JeremyProffittOrg/adafruit-pannel/docs/stl-kit.pdf

# STL isometric kit

## Base plates

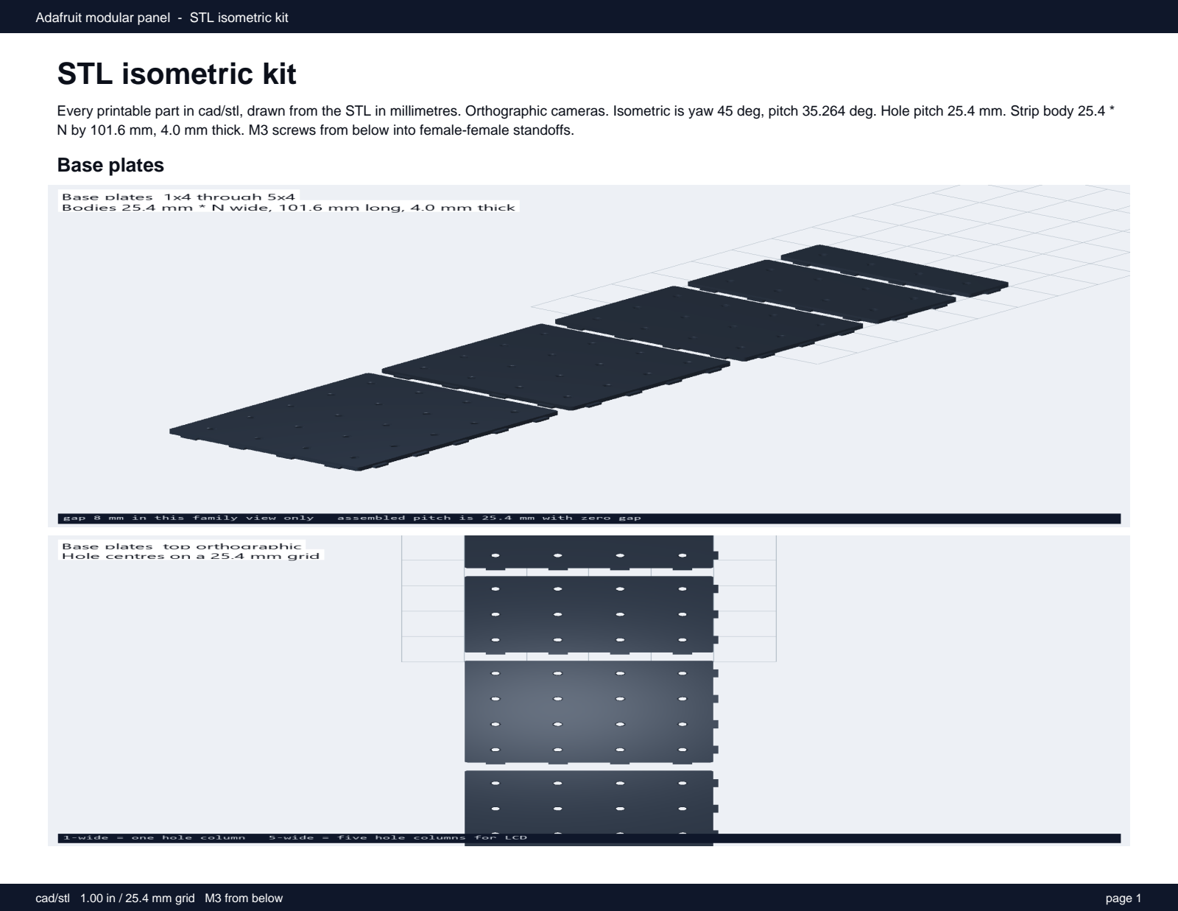
[picture p1: page 1]

Adafruit modular panel - STL isometric kit

cad/stl 1.00 in / 25.4 mm grid M3 from below | page 1

Every printable part in cad/stl, drawn from the STL in millimetres. Orthographic cameras. Isometric is yaw 45 deg, pitch 35.264 deg. Hole pitch 25.4 mm. Strip body 25.4 * N by 101.6 mm, 4.0 mm thick. M3 screws from below into female-female standoffs.

## Assembled 5-wide base and exploded stack

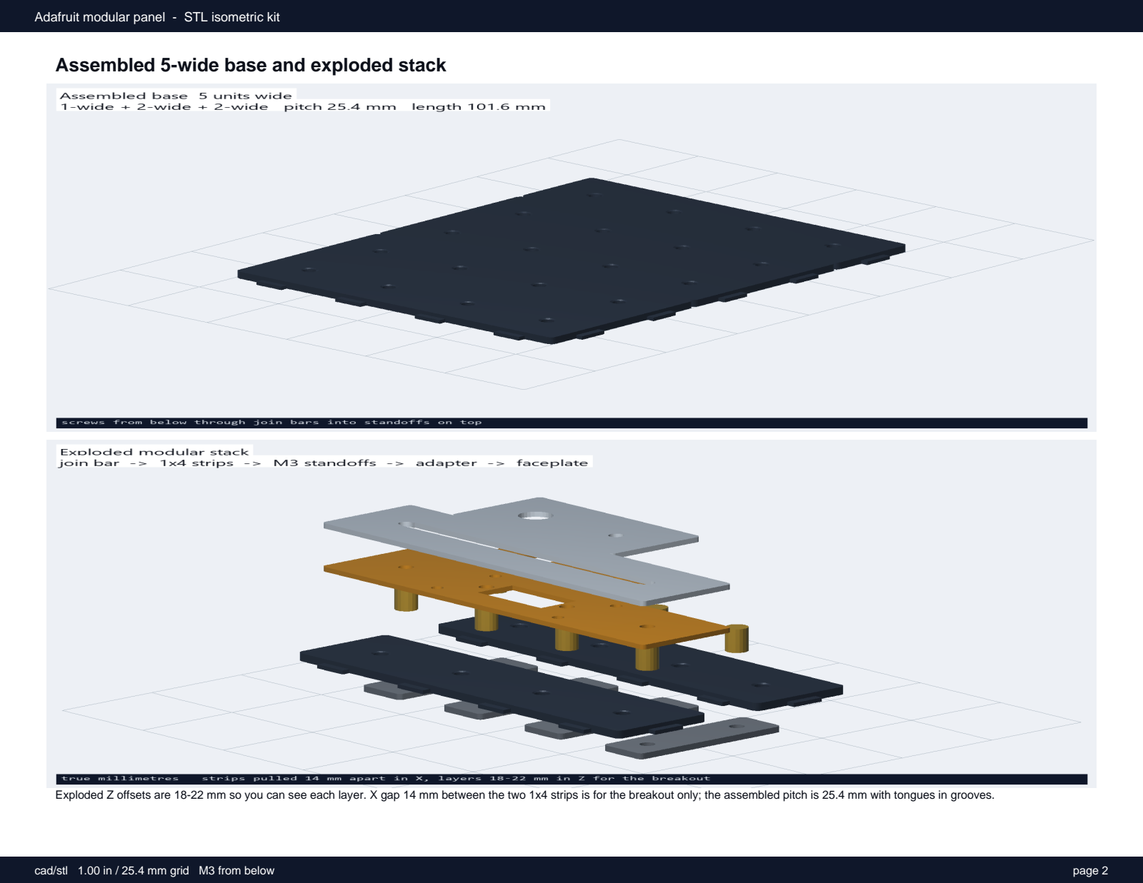
[picture p2: page 2]

Exploded Z offsets are 18-22 mm so you can see each layer. X gap 14 mm between the two 1x4 strips is for the breakout only; the assembled pitch is 25.4 mm with tongues in grooves.

## Base strip 1 x 4 (25.4 x 101.6 mm body)

Top-left isometric. Top-right reverse isometric. Bottom-left top ortho. Bottom-right side ortho.

## Base strip 2 x 4 (50.8 x 101.6 mm body)

Top-left isometric. Top-right reverse isometric. Bottom-left top ortho. Bottom-right side ortho.

## Base strip 3 x 4 (76.2 x 101.6 mm body)

Top-left isometric. Top-right reverse isometric. Bottom-left top ortho. Bottom-right side ortho.

## Base strip 4 x 4 (101.6 x 101.6 mm body)

Top-left isometric. Top-right reverse isometric. Bottom-left top ortho. Bottom-right side ortho.

## Base strip 5 x 4 (127.0 x 101.6 mm body, LCD)

Top-left isometric. Top-right reverse isometric. Bottom-left top ortho. Bottom-right side ortho.

## Join bar (40 x 12 x 3 mm, two M3 at 25.4 mm)

Top-left isometric. Top-right reverse isometric. Bottom-left top ortho. Bottom-right side ortho.

## Adapter 4991 / 5880 rotary (1 x 2 cells)

Top-left isometric. Top-right reverse isometric. Bottom-left top ortho. Bottom-right side ortho.

## Adapter 5295 NeoSlider (1 x 4 cells)

Top-left isometric. Top-right reverse isometric. Bottom-left top ortho. Bottom-right side ortho.

## Adapter 5752 quad rotary (1 x 4 cells)

Top-left isometric. Top-right reverse isometric. Bottom-left top ortho. Bottom-right side ortho.

## Adapter 6310 ANO (2 x 2 cells)

Top-left isometric. Top-right reverse isometric. Bottom-left top ortho. Bottom-right side ortho.

## Faceplate 4991 / 5880 (7.5 mm shaft hole)

Top-left isometric. Top-right reverse isometric. Bottom-left top ortho. Bottom-right side ortho.

## Faceplate 5295 (75 x 4 mm slider slot)

Top-left isometric. Top-right reverse isometric. Bottom-left top ortho. Bottom-right side ortho.

## Faceplate 5752 (four 7.5 mm shaft holes)

Top-left isometric. Top-right reverse isometric. Bottom-left top ortho. Bottom-right side ortho.

## Faceplate 6310 (22 mm click-wheel hole)

Top-left isometric. Top-right reverse isometric. Bottom-left top ortho. Bottom-right side ortho.
