JeremyProffittOrg/adafruit-pannel/docs/case-parts.pdf

Adafruit modular case - two-piece print kit

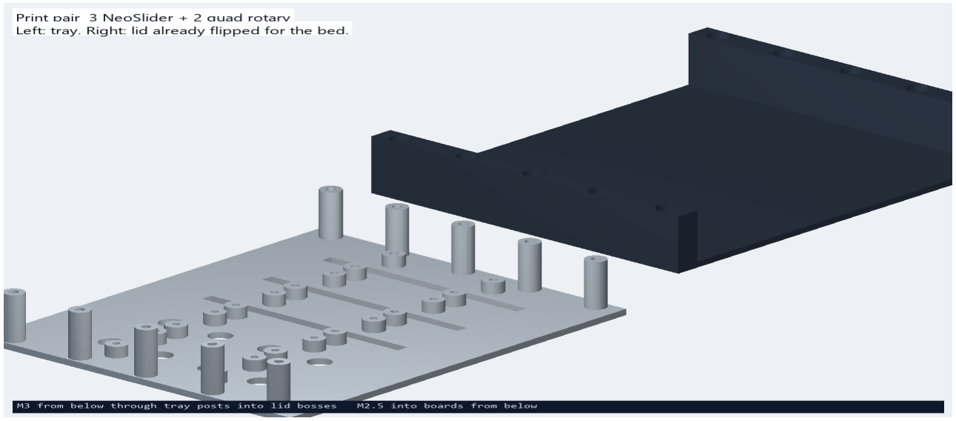
[picture p5: figure]

bottom tray + top lid 5 x 4 x 25 mm inside | page 1

# Two-piece case print kit

Bottom tray and top lid for 3 NeoSliders beside 2 quad rotaries. 5 x 4 cells, 25 mm inside. Top is already flipped: put the STL on the bed as exported. Boards screw into bosses under the lid. M3 screws come from below through the tray into the lid posts.

## Print pair

## Fit test — flip the lid over

The lid STL is already upside down for the bed. Flip it 180 deg so the posts point down, then drop it onto the two side walls. Front and back of the tray are open.

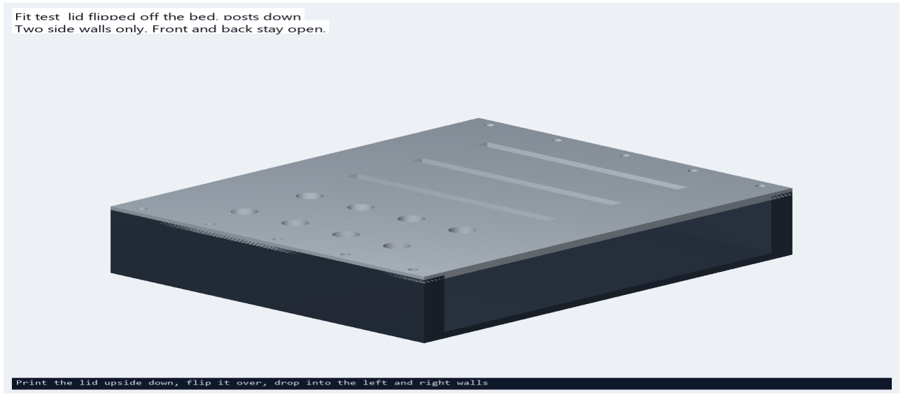
[picture p6: figure]

## Bottom tray

Iso, reverse iso, top ortho, side ortho. Millimetres from the STL.

## Top lid (print orientation)

Iso, reverse iso, top ortho, side ortho. Millimetres from the STL.

## Tilted tray demo

Iso, reverse iso, top ortho, side ortho. Millimetres from the STL.

## Tilted lid demo

Iso, reverse iso, top ortho, side ortho. Millimetres from the STL.
