JeremyProffittOrg/adafruit-pannel/cad/stl/faceplate_6310.stl

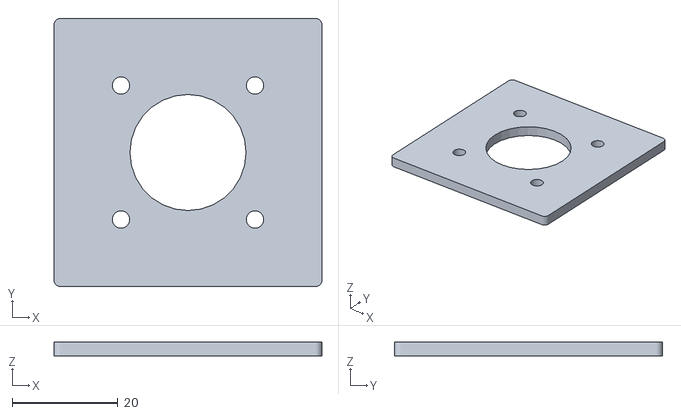
[picture p7: CAD file, 2026-09-19]
cad/stl/faceplate_6310.stl
50.8 x 50.8 x 2.60
