JeremyProffittOrg/adafruit-pannel/print-kits/sliders-quads-case/face-tilt-top.stl

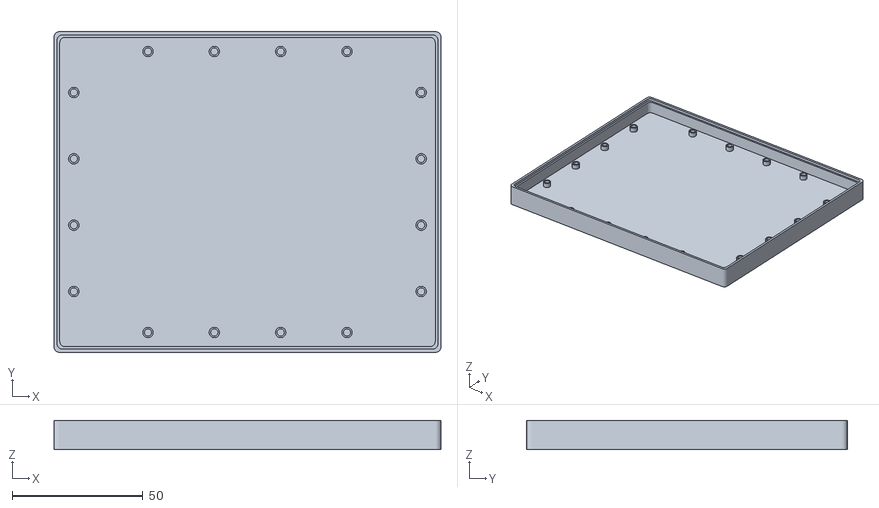
[picture p8: CAD file, 2026-09-20]
print-kits/sliders-quads-case/face-tilt-top.stl
148.2 x 122.8 x 11.2
