JeremyProffittOrg/adafruit-pannel/cad/stl/adapter_5295.stl

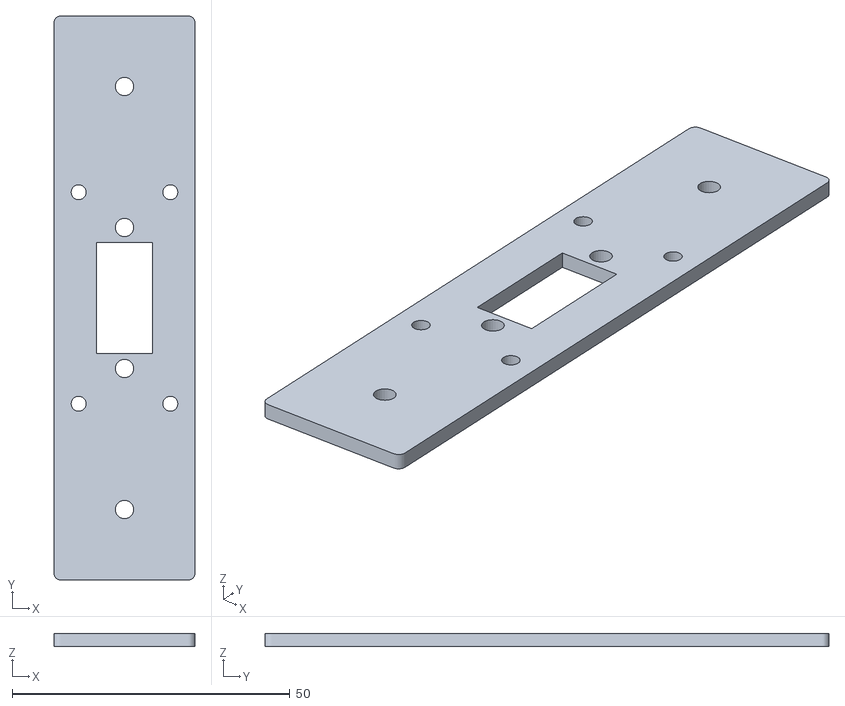
[picture p9: CAD file, 2026-09-19]
cad/stl/adapter_5295.stl
25.4 x 101.6 x 2.40
