JeremyProffittOrg/adafruit-pannel/print-kits/sliders-quads-case/top.stl

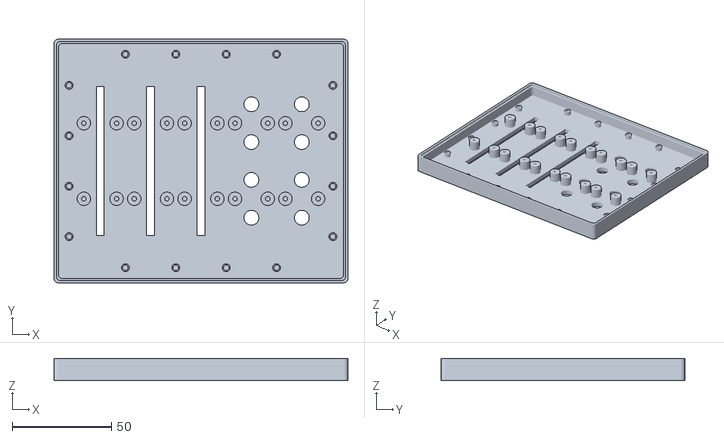
[picture p10: CAD file, 2026-09-20]
print-kits/sliders-quads-case/top.stl
148.2 x 122.8 x 11.2
