JeremyProffittOrg/adafruit-pannel/cad/stl/strip_5x4.stl

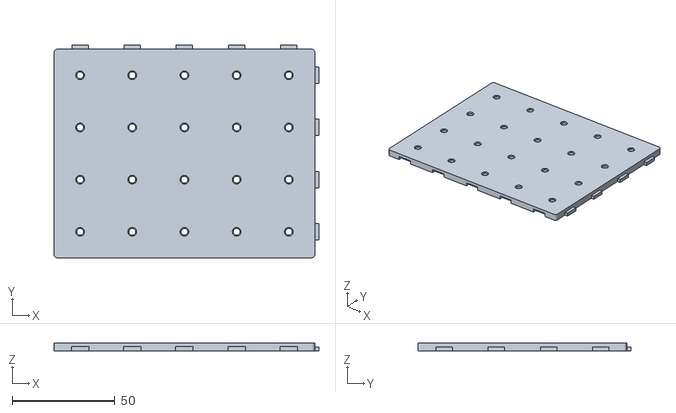
[picture p11: CAD file, 2026-09-19]
cad/stl/strip_5x4.stl
129.0 x 103.6 x 4.00
