JeremyProffittOrg/adafruit-pannel/print-kits/sliders-quads-case/bottom.stl

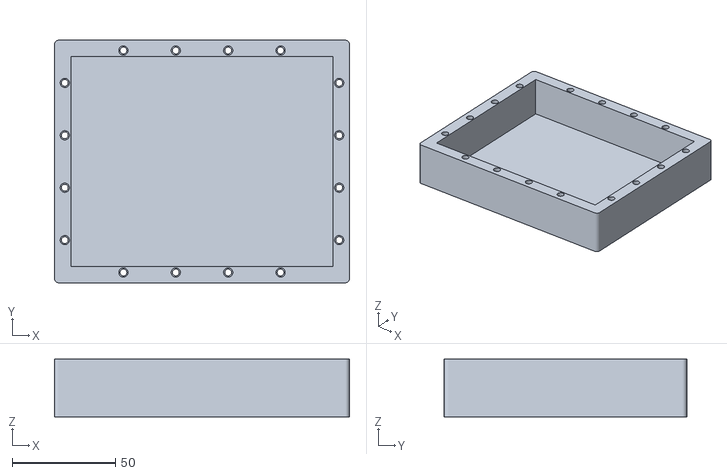
[picture p12: CAD file, 2026-09-20]
print-kits/sliders-quads-case/bottom.stl
143.0 x 117.6 x 28.0
