JeremyProffittOrg/adafruit-pannel/cad/stl/faceplate_5295.stl

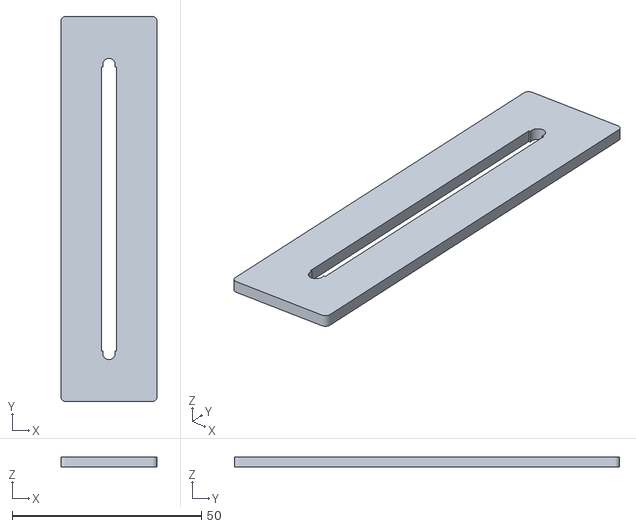
[picture p13: CAD file, 2026-09-19]
cad/stl/faceplate_5295.stl
25.4 x 101.6 x 2.60
