JeremyProffittOrg/adafruit-pannel/print-kits/sliders-quads-case/face-tilt-bottom.stl

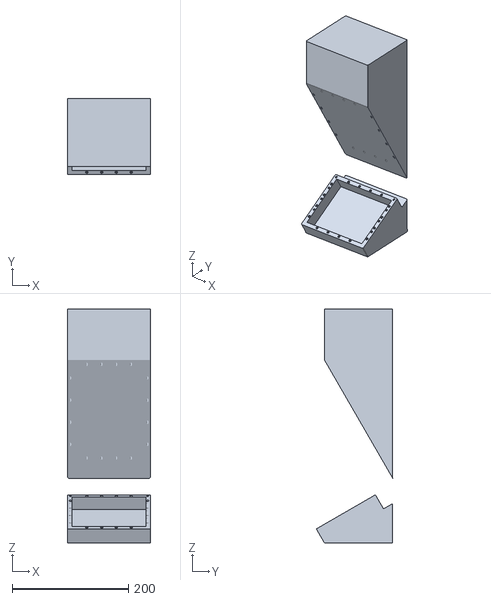
[picture p14: CAD file, 2026-09-20]
print-kits/sliders-quads-case/face-tilt-bottom.stl
143.0 x 131.6 x 403.0
