JeremyProffittOrg/adafruit-pannel/cad/stl/strip_1x4.stl

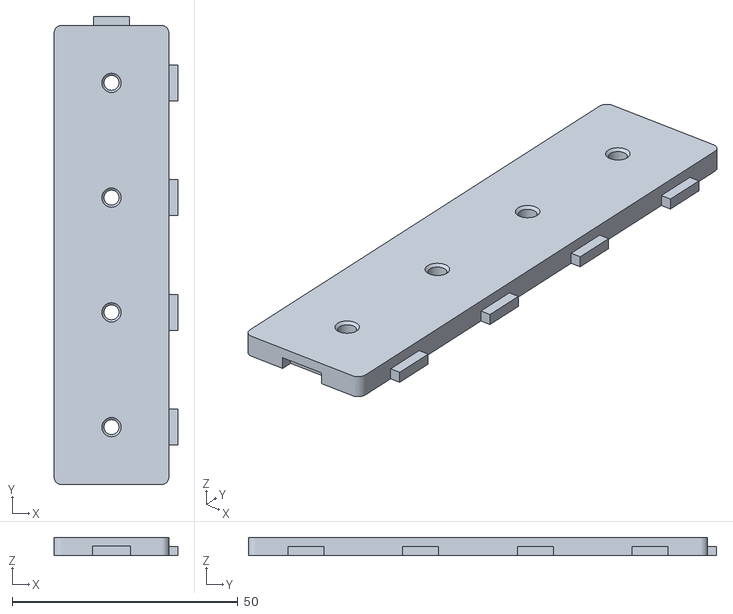
[picture p15: CAD file, 2026-09-19]
cad/stl/strip_1x4.stl
27.4 x 103.6 x 4.00
