JeremyProffittOrg/adafruit-pannel/print-kits/sliders-quads-case/sliders-quads-case.3mf

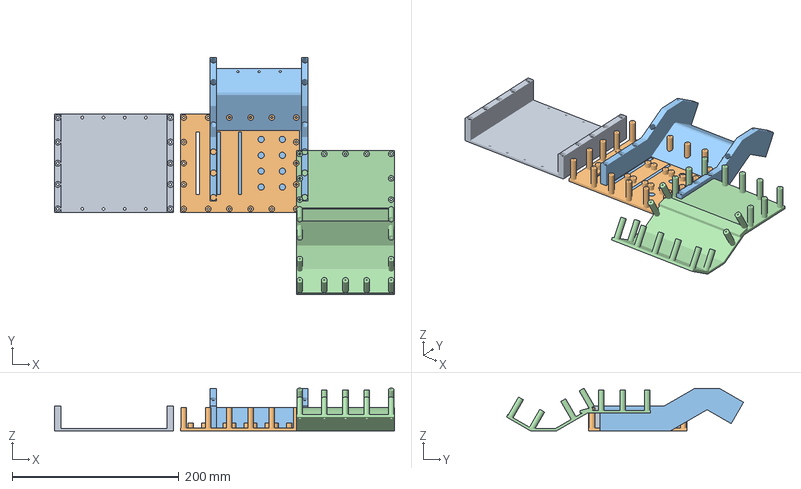
[picture p16: CAD file, 2026-09-20]
print-kits/sliders-quads-case/sliders-quads-case.3mf
407.8 x 284.4 x 51.3 mm
bottom.stl
top.stl
tilt-bottom.stl
tilt-top.stl
