JeremyProffittOrg/adafruit-pannel/cad/stl/faceplate_5752.stl

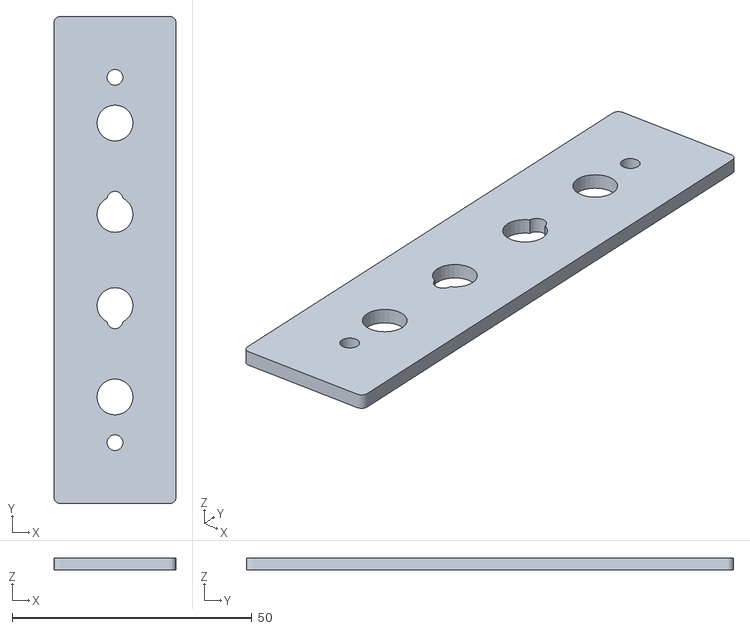
[picture p17: CAD file, 2026-09-19]
cad/stl/faceplate_5752.stl
25.4 x 101.6 x 2.60
