JeremyProffittOrg/adafruit-pannel/cad/stl/adapter_4991.stl

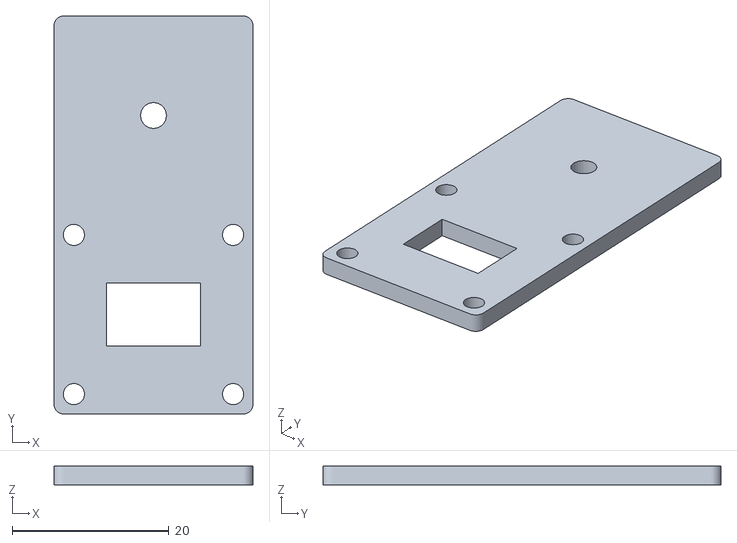
[picture p18: CAD file, 2026-09-19]
cad/stl/adapter_4991.stl
25.4 x 50.8 x 2.40
