JeremyProffittOrg/adafruit-pannel/cad/stl/faceplate_4991.stl

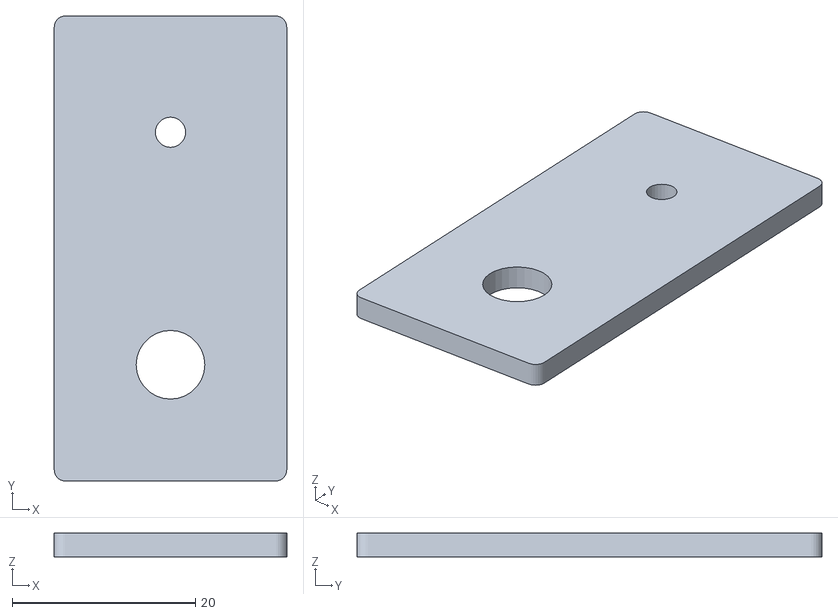
[picture p19: CAD file, 2026-09-19]
cad/stl/faceplate_4991.stl
25.4 x 50.8 x 2.60
