JeremyProffittOrg/adafruit-pannel/cad/stl/join_bar.stl

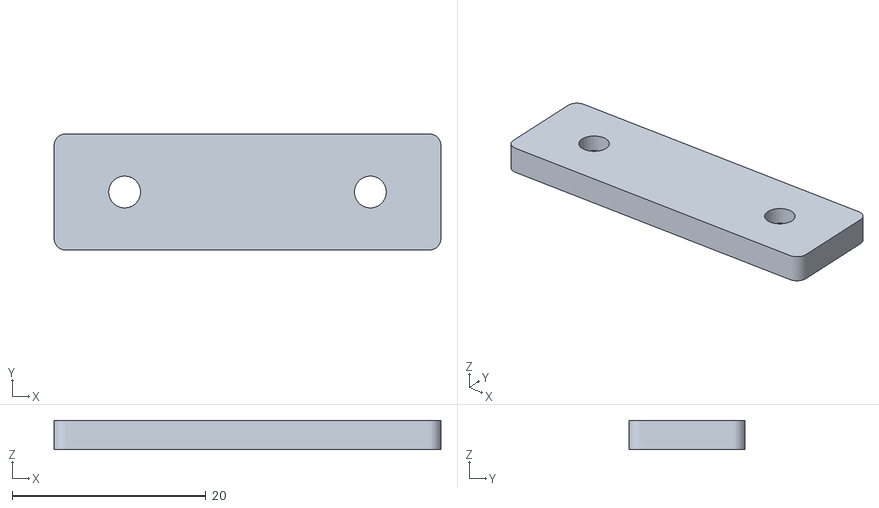
[picture p20: CAD file, 2026-09-19]
cad/stl/join_bar.stl
40.0 x 12.0 x 3.00
