JeremyProffittOrg/adafruit-pannel/cad/stl/strip_2x4.stl

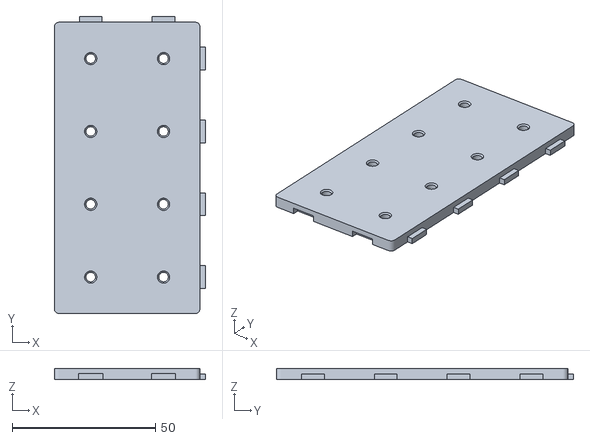
[picture p21: CAD file, 2026-09-19]
cad/stl/strip_2x4.stl
52.8 x 103.6 x 4.00
