JeremyProffittOrg/adafruit-pannel/cad/stl/strip_3x4.stl

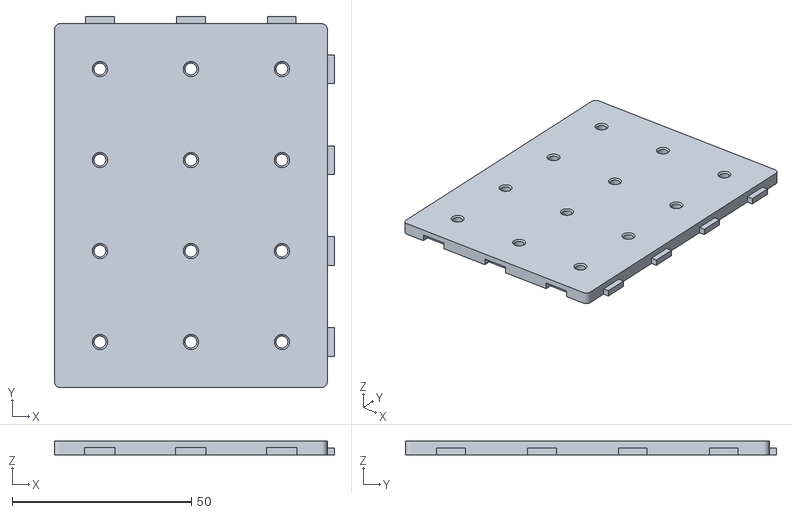
[picture p22: CAD file, 2026-09-19]
cad/stl/strip_3x4.stl
78.2 x 103.6 x 4.00
