JeremyProffittOrg/adafruit-pannel/cad/stl/adapter_6310.stl

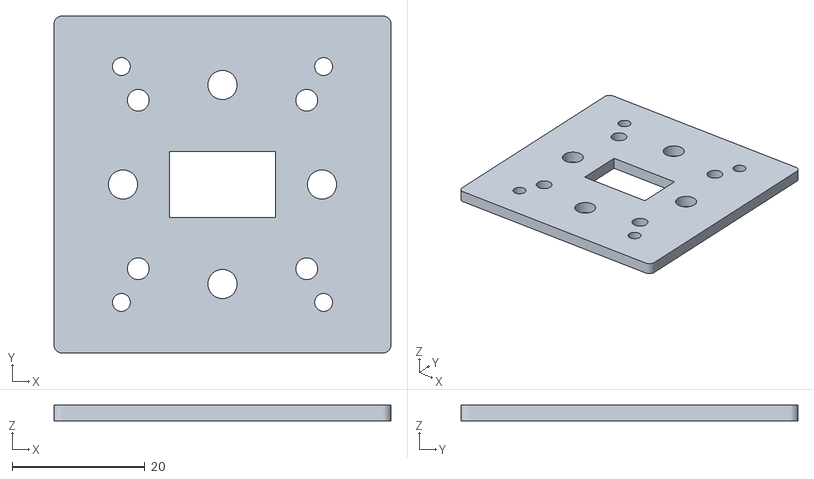
[picture p23: CAD file, 2026-09-19]
cad/stl/adapter_6310.stl
50.8 x 50.8 x 2.40
