JeremyProffittOrg/adafruit-pannel/cad/stl/strip_4x4.stl

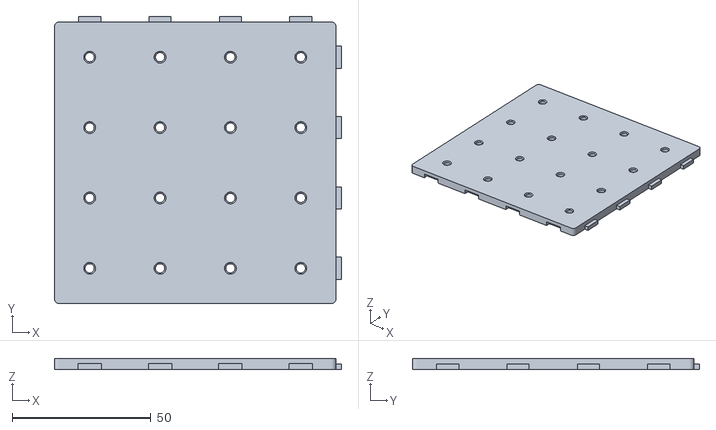
[picture p24: CAD file, 2026-09-19]
cad/stl/strip_4x4.stl
103.6 x 103.6 x 4.00
