JeremyProffittOrg/adafruit-pannel/cad/presets/sliders-quads-bottom.scad

PART = "bottom";
include <sliders-quads.scad>
include <../case.scad>
