JeremyProffittOrg/adafruit-pannel/cad/presets/sliders-quads-top-use.scad

PART = "top_use";
include <sliders-quads.scad>
include <../case.scad>
