JeremyProffittOrg/adafruit-pannel/cad/presets/sliders-quads-top.scad

PART = "top";
include <sliders-quads.scad>
include <../case.scad>
