JeremyProffittOrg/adafruit-pannel/cad/presets/sliders-quads.scad

// 3 NeoSliders beside 2 quad rotaries. 5 x 4 cells. 25 mm inside.
COLS = 5;
ROWS = 4;
INNER_H = 25;
TILTS = [0, 0, 0, 0];
NDEV = 5;
DEV_ID = ["neoslider", "neoslider", "neoslider", "quad_rotary", "quad_rotary"];
DEV_C  = [0, 1, 2, 3, 4];
DEV_R  = [0, 0, 0, 0, 0];
NWALL = 0;
