JeremyProffittOrg/adafruit-pannel/cad/presets/tilt-demo-bottom.scad

PART = "bottom";
include <tilt-demo.scad>
include <../case.scad>
