JeremyProffittOrg/adafruit-pannel/cad/presets/tilt-demo-top-use.scad

PART = "top_use";
include <tilt-demo.scad>
include <../case.scad>
