JeremyProffittOrg/adafruit-pannel/cad/presets/tilt-demo-top.scad

PART = "top";
include <tilt-demo.scad>
include <../case.scad>
