JeremyProffittOrg/adafruit-pannel/cad/presets/tilt-demo.scad

// 3 rows flat, 2 rows at +30 deg, 1 row at -30 deg. Width 4. Empty cells.
COLS = 4;
ROWS = 6;
INNER_H = 25;
TILTS = [0, 0, 0, 30, 30, -30];
NDEV = 0;
NWALL = 0;
