JeremyProffittOrg/adafruit-pannel/(commit log)

2026-09-19 Add 1.00 in 3D-printable Adafruit control-panel grid and catalog PDF
    [adapter_4991.stl, adapter_5295.stl, adapter_5752.stl, adapter_6310.stl, faceplate_4991.stl, faceplate_5295.stl, faceplate_5752.stl, faceplate_6310.stl]
2026-09-19 Add STL isometric kit PDF and 60s 480p modular promo
2026-09-19 Replace strip stack with two-piece case and Go layout site
    [bottom.stl, case.scad, devices.scad, sliders-quads-bottom.scad, sliders-quads-case.3mf, sliders-quads-top.scad, sliders-quads.scad, tilt-demo-bottom.scad]
2026-09-19 Add two-piece case parts PDF and app start shortcuts
2026-09-19 Move case posts into the lid rim and close angled side walls
    [bottom.stl, case.scad, sliders-quads-case.3mf, tilt-bottom.stl, tilt-top.stl, top.stl]
2026-09-19 Seat lid posts in the two side walls and flip the lid in the fit test
    [bottom.stl, case.scad, tilt-bottom.stl, tilt-top.stl, top.stl]
2026-09-19 Rebuild case-parts PDF and promo v2
2026-09-19 Closed four-wall case, world-Z rim posts, live 3D preview, bigger device library
    [bottom.stl, case.scad, devices.scad, tilt-bottom.stl]
2026-09-19 Show every device cutout, PCB, and boss in the live 3D preview
2026-09-19 Shoebox lid with skirt and short pegs; add quality gates
    Closed four-wall tray. Lid drops on with an outer skirt and 2.5 mm
    rim pegs. M3 from below. No through-wall sockets. python
    scripts/quality_gate.py --preset sliders-quads (and tilt-demo)
    passes components, assemble, and enclosure.
    [bottom.stl, case.scad, sliders-quads-top-use.scad, tilt-bottom.stl, tilt-demo-top-use.scad, tilt-top.stl, top.stl]
2026-09-19 Live site on ap.jeremy.ninja: Fiber Lambda, LWA, DynamoDB cases
    SAM deploy from GitHub Actions (OIDC). Login with Amazon. Folders,
    saved cases, notes, search, cases-by-part. Zip includes BOM with
    manufacturer URLs. LWA setup script is scripts/setup-lwa.cmd.
2026-09-19 Use SAM-managed us-east-1 bucket; clear rolled-back stack
2026-09-19 Three persona passes on the live builder
    Round 1: frame the 3D case, mobile wrap, hide empty library,
    BOM on the page, new/save-as, confirm delete, named zip,
    security headers, layout validation.
    Round 2: hardware lines in BOM, new empty case, error paths,
    folder name limits.
    Round 3: device filter label, live status region, favicon.
2026-09-19 Add case-animation and site-intro video scripts
2026-09-19 Align Case fields in a two-column table with right-justified labels
2026-09-19 Share one Case table so labels and inputs share a column
2026-09-19 Keep Case label and input columns aligned through row-tilt rows
2026-09-19 Cache-bust Case table CSS and JS
2026-09-19 Keep Case labels on one line: Inside mm
2026-09-19 Futuristic PCB-trace and city-skyline theme
2026-09-19 Fix review defects from eight parallel slice reviews.
    Keep the brand tooltip above the Case column, open it on tap, and stop the city skyline washing out. Clone layouts on load, save into the case folder not the filter, and put CAD sources in the zip. World-Z pegs, tilted lid holes, no-store on login cookies, and DynamoDB Query without Scan. Quality gates pass both presets.
    [bottom.stl, case.scad, tilt-bottom.stl, tilt-top.stl, top.stl]
2026-09-19 Hang tilt-case skirts in world Z so the lid still drops on.
    Angled rows used local-Z skirts, which opened a notch at every kink and left the back of the -30 deg row uncovered. Side skirts now hang straight down in world Z, with hulls at kinks, matching the tray side walls. Preview matches. Quality gates pass.
    [case.scad, tilt-top.stl]
2026-09-19 Add keyholes on the back wall so the case can hang on screws.
    Two #8 / M4 keyholes through the back wall, on by default, with a Case checkbox to turn them off. BOM lists the wall screws. Quality gates pass both presets.
    [bottom.stl, case.scad, tilt-bottom.stl]
2026-09-19 Add a mobile bottom tab bar with icons for View, Case, Parts, and Library.
2026-09-19 Put case title and 3D view controls on the panes that use them.
    Guests could not name a zip because title lived in Library. Together/Bottom/Top sat on Case, so phones could not change the 3D view from View. BOM now fills default edge round 2 mm when those fields are omitted.
2026-09-19 Make lid-to-tray overlap a yes/no case option.
    Yes keeps the shoebox skirt over the tray walls. No is a flush lid on the wall tops, pegs still locate it.
    [case.scad]
2026-09-19 Place hang keyholes on any wall and choose slot direction.
    Add hang holes on back, front, left, or right at a cell index. Slot down, up, left, or right is which way the case drops onto the screws.
    [case.scad]
2026-09-19 Add face tilt and bottom hang holes for wall-leaning panels.
    Case option face_tilt 0-45 rotates the tray about the front sitting
    edge and prints a foot. Hang side bottom cuts keyholes through that
    foot so a 30 degree wall panel can lean out toward the user.
    [case.scad]
2026-09-19 Add a Bambu Studio project file and an Open in Bambu Studio button.
    When OpenSCAD can render the tray and lid, the zip includes case.3mf
    with both meshes on one plate. Open in Bambu Studio hosts that 3mf
    and launches bambustudio:// so Studio can open it on the computer.
2026-09-19 Add, drag, duplicate, and remove devices on the layout and 3D view.
    Add device places the selected part in the first free cells and grows
    the case when it needs more width. Drag a part onto the 3D preview or
    the grid to place it. Placed parts have dup and remove, and can be
    dragged to a new cell.
2026-09-19 Replace row-degree fields with a tilt wizard for rows or columns.
    Fold is flat, by rows (front to back), or by columns (left to right).
    Each strip gets angle chips instead of a Row N (deg) list. CAD and
    preview fold on the chosen axis.
    [case.scad]
2026-09-19 Rename overlap to Top overhang and round tray, lid, and skirt.
    [case.scad]
2026-09-19 Put Library, Case, and Device on the left with top tabs.
2026-09-19 Make the top layout a graphical board with auto columns and rows.
2026-09-19 Put Download and Bambu in the header and move the BOM to its own tab.
2026-09-20 Ignore generated local media and keep the current Bambu kit 3mf.
    [sliders-quads-case.3mf]
2026-09-20 Add face-tilt floor fill, base grid, compact builder UI, and Bambu 3mf metadata.
    [bottom.stl, case.scad, face-tilt-bottom.stl, face-tilt-top.stl, tilt-bottom.stl, tilt-top.stl, top.stl]
2026-09-20 Show build status beside Bambu and spin the waiting button.
2026-09-20 Fit 3D preview and top layout into the original preview slot when beside.
2026-09-20 Hide the empty-cell eraser from the device list.
2026-09-20 Point the site at case-maker.jeremy.ninja.
